Strooom/LoRa-V3-Mini-PCB/outputs/reports/PCB design-rule-check report.html

Logo

| DRC report for LoRa-V3-Mini-PCB
| PCB: LoRa-V3-Mini-PCB Revision: None Date: 2025-06-02T10:16:57+0000 KiCad Version: 8.0.8 | Errors: 0 Warnings: 1 Total: 1

Violations

Type | Description | Details
lib_footprint_mismatch | Footprint 'XDCR_ANT-868-CHP-T' does not match copy in library '1projectLibrary'. | @(171.91 mm, 107.25 mm): Footprint ANT1

Generated by KiBot (https://github.com/INTI-CMNB/KiBot/) v1.8.5
