Strooom/LoRa-V3-Mini-PCB/outputs/reports/schematic electrical-rule-check report.html

Logo

| ERC report for LoRa-V3-Mini-PCB
| Schematic: LoRa-V3-Mini-PCB Revision: V1.2 Date: 2025-06-02T10:16:55+0000 KiCad Version: 8.0.8 | Errors: 0 Warnings: 3 Total: 3

Sheet / (LoRa-V3-Mini-PCB.kicad_sch)

Type | Description | Details
global_label_dangling | Global label not connected anywhere else in the schematic | @(2.3749 mm, 0.762 mm): Global Label 'TEST0'
lib_symbol_issues | The current configuration does not include the library '1GlobalSymbolsLibrary' | @(2.2352 mm, 1.4351 mm): Symbol SW2 [Switch_435451019820]
lib_symbol_issues | The current configuration does not include the library '1GlobalSymbolsLibrary' | @(0.4445 mm, 0.9779 mm): Symbol U3 [SHT40]

Generated by KiBot (https://github.com/INTI-CMNB/KiBot/) v1.8.5
