Strooom/LoRa-V3-Mini-PCB/outputs/bom/LoRa-V3-Mini-PCB-bom.html

 | KiBot Bill of Materials
 | Schematic: LoRa-V3-Mini-PCB Variant: default Revision: V1.2 Date: 2024-07-26 KiCad Version: 8.0.8+1 | Component Groups: 14 Component Count: 20 (per PCB) Fitted Components: 20 (per PCB) Number of PCBs: 1 Total Components: 20 (for 1 PCBs)
References | Part | Value | Quantity Per PCB | manufacturerName | manufacturerPartNumber | octopartUrl
ANT1 | Antenna_Chip | Chip Antenna | 1 | TE Connectivity Linx | ANT-868-CHP-T | https://octopart.com/search?q=ANT-868-CHP-T¤cy=USD&specs=0
BH1 | Battery_Cell | Battery Holder | 1 | KeyStone | 108 | https://octopart.com/108-keystone-11058
C1 C2 C3 C5 | C | 100nF | 4 | TDK | CGA3E2X7R1E104K080AA | https://octopart.com/cga3e2x7r1e104k080aa-tdk-25947977?r=sp
C10 C11 | C | 4.7uF | 2 | Samsung | CL21B475KPFNFNE | https://octopart.com/cl21b475kpfnfne-samsung+electro-mechanics-24958210
CONN2 | CLI_Conn_01x03_Pin | UART2 - CLI | 1 | NA | NA | NA
Q1 | Si2367DS | NA | 1 | Vishay Siliconix | SI2367DS-T1-GE3 | https://octopart.com/si2367ds-t1-ge3-vishay-42637886?r=sp
R1 R2 R3 | R | 4K7 | 3 | YAGEO | CR0603-FX-4701ELF | https://octopart.com/cr0603-fx-4701elf-bourns-3867100?r=sp
R4 | R | 330K | 1 | YAGEO | AC0603JR-07330KL | https://octopart.com/ac0603jr-07330kl-yageo-30510863
SW1 | Switch_434331045822 | Application Button | 1 | Wurth Electronics | 434331045822 | https://octopart.com/434331045822-wurth+elektronik-22866031
SW2 | Switch_435451019820 | MCU Reset | 1 | Wurth Elektronik | 434133025816 | https://octopart.com/434133025816-wurth+elektronik-99472342
U2 | BR24G1MFVT | BR24G1MFVT | 1 | ROHM | BR24G1MFVT-5AE2 | https://octopart.com/br24g1mfvt-5ae2-rohm-126430213?r=sp
U3 | SHT40 | SHT40 | 1 | Sensirion | SHT40-BD1B-R2 | https://octopart.com/sht40-bd1b-r2-sensirion-137454263?r=sp
U1 | Seeed_Wio-E5 | Seeed_Wio-E5 LE | 1 | Seeed Technology | 114993121 | https://octopart.com/114993121-seeed+studio-142683940?r=sp
U4 | TSL2591 | TSL25911 | 1 | ams Osram | TSL25911FN | https://octopart.com/tsl25911fn-osram-126135547?r=sp
Color reference for columns:
KiCad Fields (default)
Generated Fields
User Fields
Empty Fields
