Strooom/LoRa-V3-Mini-PCB/outputs/bom/kicost-bom.xlsx

Prj: | kicost-bom.csv |  |  |  | Board Qty: | 100
Co.: |  |  |  |  | Unit Cost: | €97.44
Prj date: | 2025-03-11 14:46:47 (file) |  |  |  | Total Cost: | €9743.70 |  |  |  |  | €9743.70 | 14 of 14 parts found
$ date: | 2025-03-12 16:15:15
Global Part Info |  |  |  |  |  |  | Mouser
Refs | Value | Footprint | Manf# | Qty | Unit$ | Ext$ | Avail | Purch | Unit$ | MOQ | Ext$ | Cat#
ANT1 | ??? | ??? | ANT-868-CHP-T (https://www.mouser.com/datasheet/2/418/9/lnncs00024_1-3238509.pdf) | 100 | €2.620 | €262.00 | 643 |  | €2.620 | 1 | €262.00 | 712-ANT-868-CHP-T (https://www.mouser.be/ProductDetail/TE-Connectivity-Linx-Technologies/ANT-868-CHP-T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)
BH1 | ??? | ??? | 108 (https://www.mouser.com/datasheet/2/643/ds_st_rectifiers_series-1384684.pdf) | 100 | €81.890 | €8189.00 | NonStk |  | €81.890 | 1 | €8189.00 | 530-10-8 (https://www.mouser.be/ProductDetail/Bel-Signal-Transformer/10-8?qs=0%2F2GmT7MRM%2FiGa7OCQo%252Bvw%3D%3D)
C1-C3,C5 | ??? | ??? | CGA3E2X7R1E104K080AA | 400 | €0.019 | €7.60 | 928170 |  | €0.019 | 1 | €7.60 | 810-CGA3E2X7R1E104K (https://www.mouser.be/ProductDetail/TDK/CGA3E2X7R1E104K080AA?qs=NRhsANhppD%2Fm7%2FOmmsm0vg%3D%3D)
C10,C11 | ??? | ??? | CL21B475KPFNFNE (https://www.mouser.com/datasheet/2/585/MLCC-1837944.pdf) | 200 | €0.105 | €21.00 | 16674 |  | €0.105 | 1 | €21.00 | 187-CL21B475KPFNFNE (https://www.mouser.be/ProductDetail/Samsung-Electro-Mechanics/CL21B475KPFNFNE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)
CONN2 | ??? | ??? | NA (https://www.mouser.com/datasheet/2/1628/ac_c5_na-3519839.pdf) | 100 |  |  | NonStk |  |  | 700 |  | 179-AC-C5-L-BNA (https://www.mouser.be/ProductDetail/Same-Sky/AC-C5-L-B-NA?qs=%252BXxaIXUDbq377a9viFQN2A%3D%3D)
Q1 | ??? | ??? | SI2367DS-T1-GE3 | 100 | €0.245 | €24.50 | 5668 |  | €0.245 | 1 | €24.50 | 781-SI2367DS-GE3 (https://www.mouser.be/ProductDetail/Vishay-Semiconductors/SI2367DS-T1-GE3?qs=kt16UJ73eEHbeglRjuryig%3D%3D)
R1-R3 | ??? | ??? | CR0603-FX-4701ELF (https://www.mouser.com/datasheet/2/54/cr-1858361.pdf) | 300 | €0.008 | €2.40 | 190615 |  | €0.008 | 1 | €2.40 | 652-CR0603FX-4701ELF (https://www.mouser.be/ProductDetail/Bourns/CR0603-FX-4701ELF?qs=CCIlxZRRv7jGwxSydcgiTA%3D%3D)
R4 | ??? | ??? | AC0603JR-07330KL (https://www.mouser.com/datasheet/2/447/PYu_AC_51_RoHS_L_11-3418659.pdf) | 100 | €0.007 | €0.70 | 64642 |  | €0.007 | 1 | €0.70 | 603-AC0603JR-07330KL (https://www.mouser.be/ProductDetail/YAGEO/AC0603JR-07330KL?qs=ygRr%2FtkhteswRX2BvSPS%2Fg%3D%3D)
SW1 | ??? | ??? | 434351045816 | 100 | €0.466 | €46.60 | 2739 |  | €0.466 | 1 | €46.60 | 710-434351045816 (https://www.mouser.be/ProductDetail/Wurth-Elektronik/434351045816?qs=wr8lucFkNMUGT%2FvJONN5XA%3D%3D)
SW2 | ??? | ??? | 434133025816 | 100 | €0.469 | €46.90 | 2166 |  | €0.469 | 1 | €46.90 | 710-434133025816 (https://www.mouser.be/ProductDetail/Wurth-Elektronik/434133025816?qs=sPbYRqrBIVmKpJ9kaO4kMw%3D%3D)
U1 | ??? | ??? | 114993121 (https://www.mouser.com/datasheet/2/744/Wio_E5_LE_module_datasheet_v1_0-3446934.pdf) | 100 | €7.640 | €764.00 | 96 |  | €7.640 | 1 | €764.00 | 713-114993121 (https://www.mouser.be/ProductDetail/Seeed-Studio/114993121?qs=QpmGXVUTftF1SD6oRXq2Mw%3D%3D)
U2 | ??? | ??? | BR24G1MFVT-5AE2 | 100 | €1.210 | €121.00 | 3347 |  | €1.210 | 1 | €121.00 | 755-BR24G1MFVT-5AE2 (https://www.mouser.be/ProductDetail/ROHM-Semiconductor/BR24G1MFVT-5AE2?qs=MyNHzdoqoQKnzx5taP2O%252BA%3D%3D)
U3 | ??? | ??? | SHT40-BD1B-R2 (https://www.mouser.com/datasheet/2/682/HT_DS_Datasheet_SHT4x_3-2936319.pdf) | 100 | €1.160 | €116.00 | 3188 |  | €1.160 | 1 | €116.00 | 403-SHT40-BD1B-R2 (https://www.mouser.be/ProductDetail/Sensirion/SHT40-BD1B-R2?qs=ulEaXIWI0c%252BjgdkzNQkrGw%3D%3D)
U4 | ??? | ??? | TSL25911FN (https://www.mouser.com/datasheet/2/588/asset_pdf_25493382-3432823.pdf) | 100 | €1.420 | €142.00 | 8371 |  | €1.420 | 1 | €142.00 | 985-TSL25911FN (https://www.mouser.be/ProductDetail/ams-OSRAM/TSL25911FN?qs=6irNfxKJ9AaiNMbaQmyIug%3D%3D)
 |  |  |  |  | Total Purchase: | €0.00 | Buy here (https://mouser.com/bom/) |  |  |  | €0.00
KiCost® v1.1.19 |  |  |  |  | Purchase description:
