Strooom/LoRa-V3-Mini-PCB/inputs/3dmodels/TSSOP8.STEP

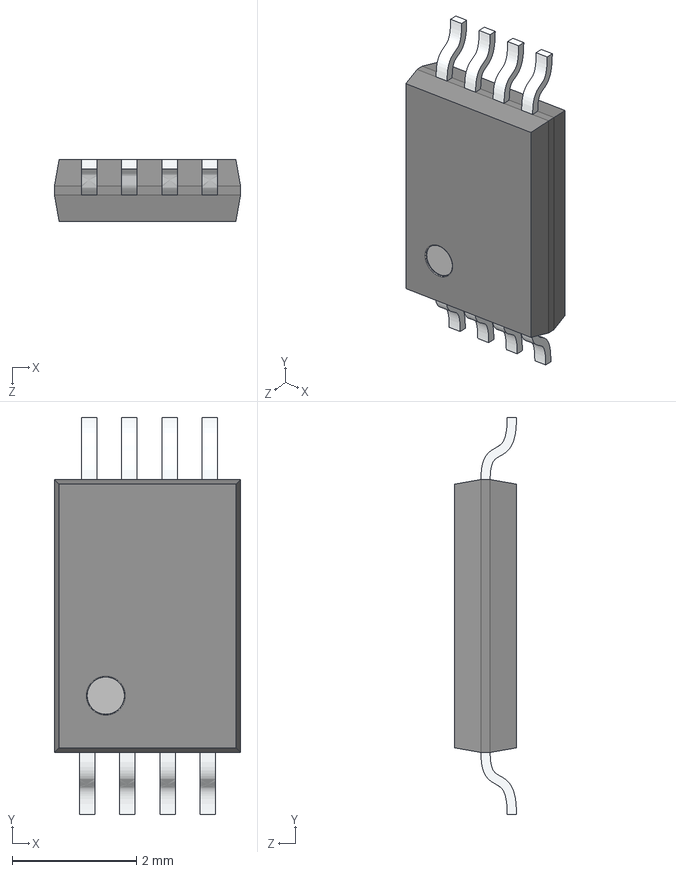
[picture p2: CAD file, 2025-03-11]
inputs/3dmodels/TSSOP8.STEP
3.00 x 6.40 x 1.00 mm
