Strooom/LoRa-V3-Mini-PCB/outputs/pcb/LoRa-V3-Mini-PCB-3D.step

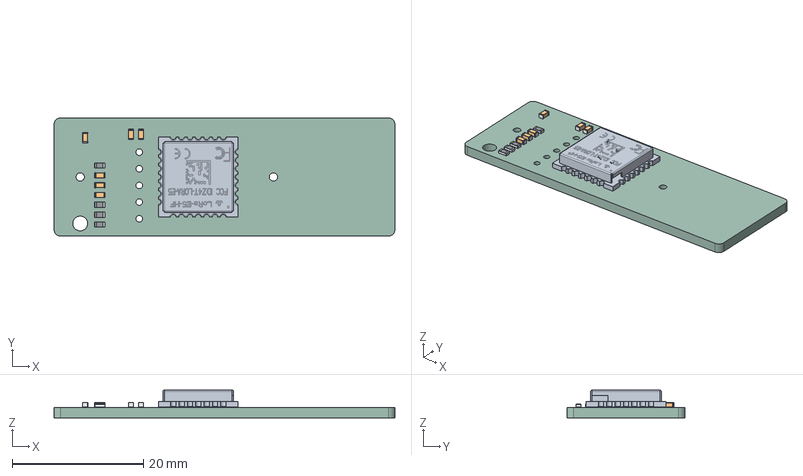
[picture p3: CAD file, 2024-10-09]
outputs/pcb/LoRa-V3-Mini-PCB-3D.step
52.0 x 18.0 x 4.26 mm
LORA-E5-HF00
kibot_l9_deagh_PCB
