Strooom/LoRa-V3-Mini-PCB/inputs/3dmodels/SON-06-FN_2000X2400_AMS.step

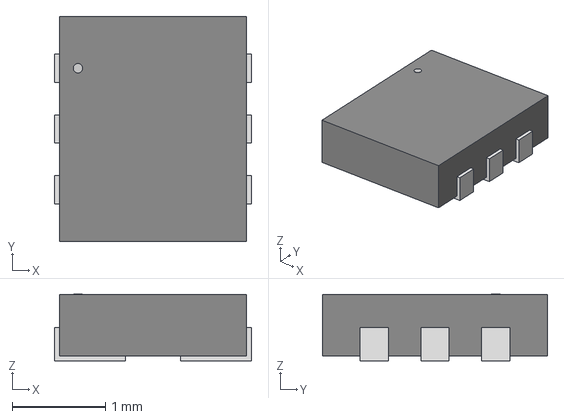
[picture p4: CAD file, 2025-03-11]
inputs/3dmodels/SON-06-FN_2000X2400_AMS.step
2.11 x 2.41 x 0.714 mm
