Strooom/LoRa-V3-Mini-PCB/inputs/3dmodels/Saft 14250.step

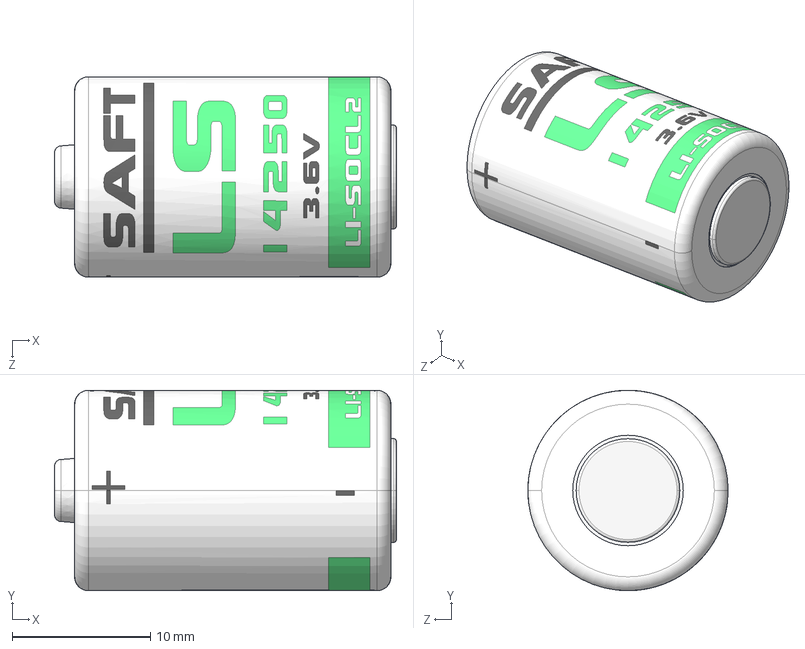
[picture p5: CAD file, 2025-03-11]
inputs/3dmodels/Saft 14250.step
24.8 x 14.5 x 14.5 mm
