Strooom/LoRa-V3-Mini-PCB/inputs/3dmodels/SOT23.STEP

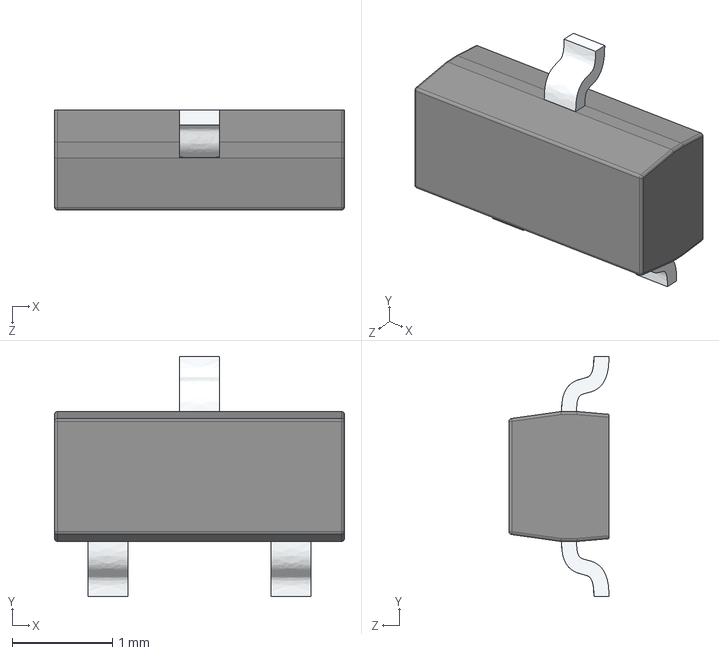
[picture p7: CAD file, 2025-03-11]
inputs/3dmodels/SOT23.STEP
2.90 x 2.40 x 1.00 mm
