Strooom/LoRa-V3-Mini-PCB/inputs/3dmodels/SHT40-AD1B-R2.step

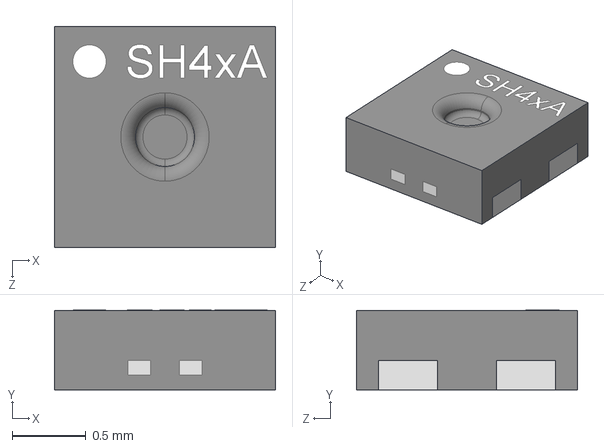
[picture p8: CAD file, 2024-10-09]
inputs/3dmodels/SHT40-AD1B-R2.step
1.50 x 0.541 x 1.50 mm
