Strooom/LoRa-V3-Mini-PCB/inputs/3dmodels/Keystone-108.stp

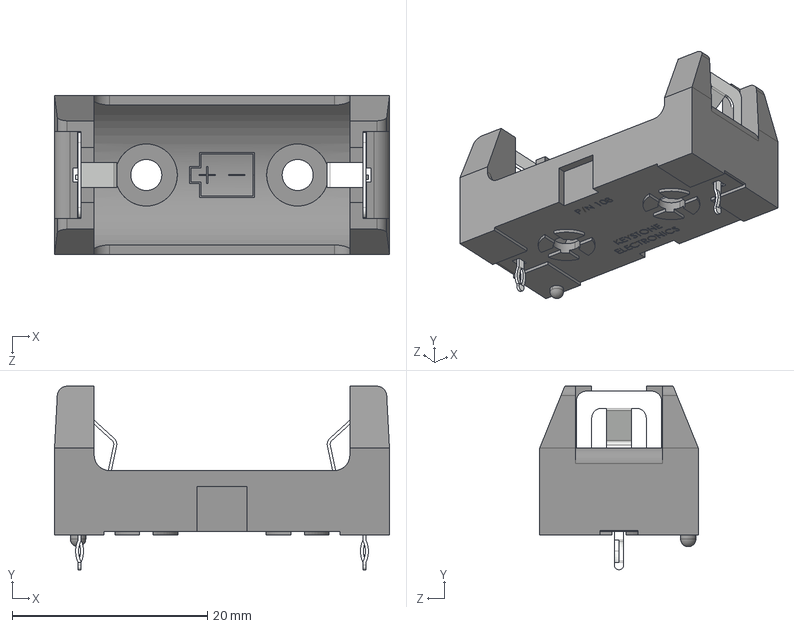
[picture p9: CAD file, 2024-10-09]
inputs/3dmodels/Keystone-108.stp
34.3 x 18.8 x 16.3 mm
