Strooom/LoRa-V3-Mini-PCB/inputs/3dmodels/LoRa-E5-HF_3D_File.stp

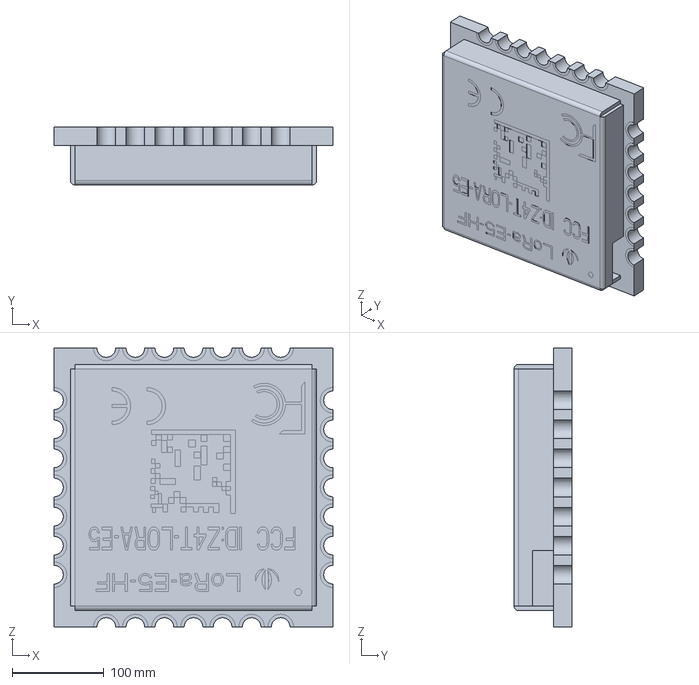
[picture p10: CAD file, 2024-10-09]
inputs/3dmodels/LoRa-E5-HF_3D_File.stp
304.8 x 63.8 x 304.8 mm
