Strooom/LoRa-V3-Mini-PCB/inputs/3dmodels/ANT-868-CHP-T.step

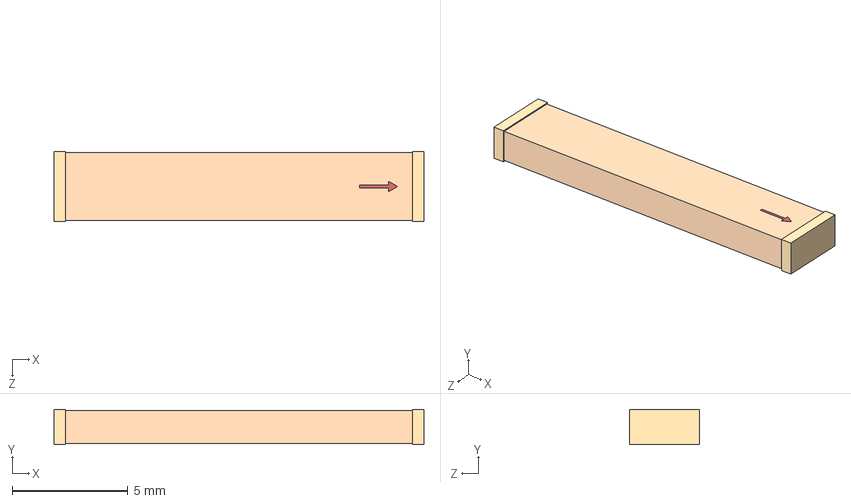
[picture p11: CAD file, 2024-10-09]
inputs/3dmodels/ANT-868-CHP-T.step
16.0 x 1.52 x 3.05 mm
