Strooom/LoRa-V3-Mini-PCB/inputs/3dmodels/R0603.step

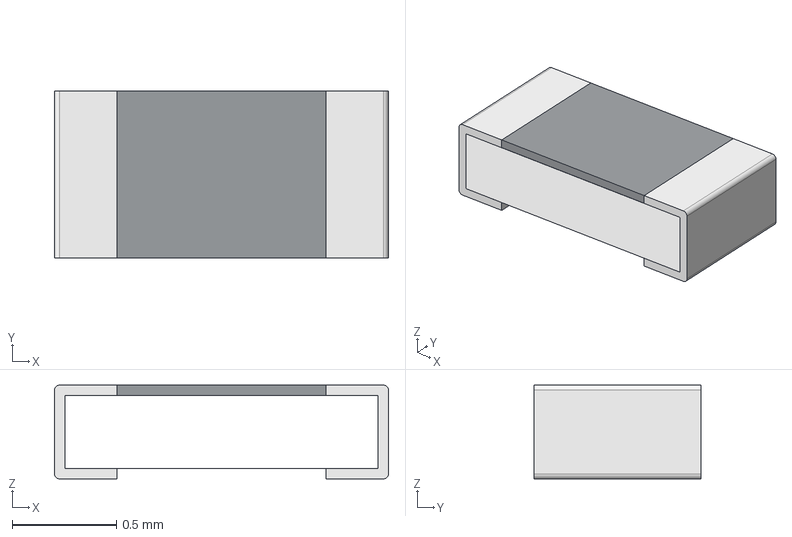
[picture p12: CAD file, 2024-10-09]
inputs/3dmodels/R0603.step
1.60 x 0.8 x 0.45 mm
