Strooom/LoRa-V3-Mini-PCB/inputs/3dmodels/434331045822.stp

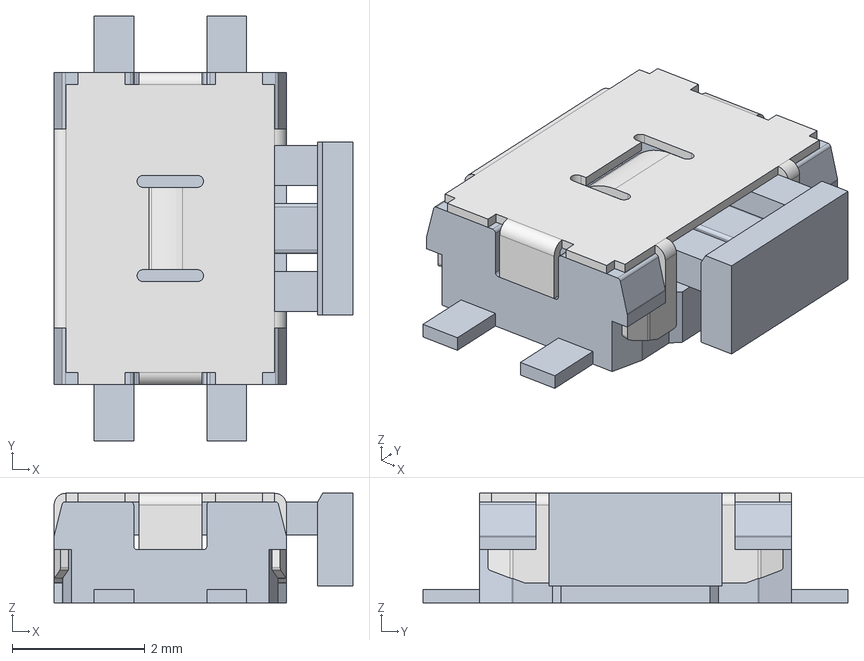
[picture p14: CAD file, 2025-03-11]
inputs/3dmodels/434331045822.stp
4.50 x 6.40 x 1.65 mm
