Strooom/LoRa-V3-Mini-PCB/inputs/3dmodels/4341x30258x6.stp

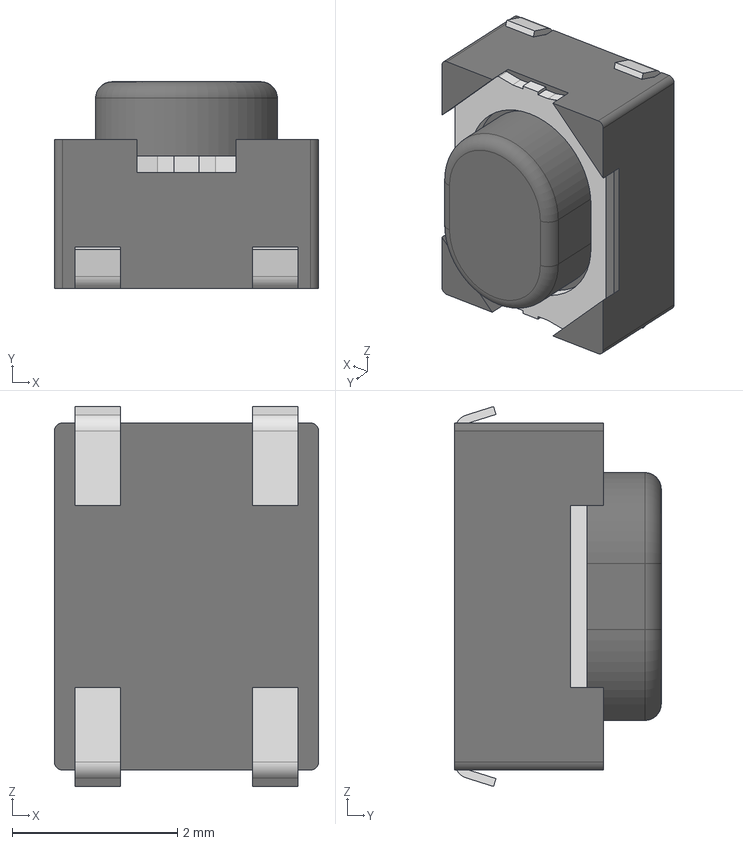
[picture p15: CAD file, 2025-03-11]
inputs/3dmodels/4341x30258x6.stp
3.20 x 2.50 x 4.60 mm
Frame
Cover
Stem
Terminal x 4
