Strooom/LoRa-V3-Mini-PCB/outputs/schematic/LoRa-V3-Mini-PCB-schematic.pdf

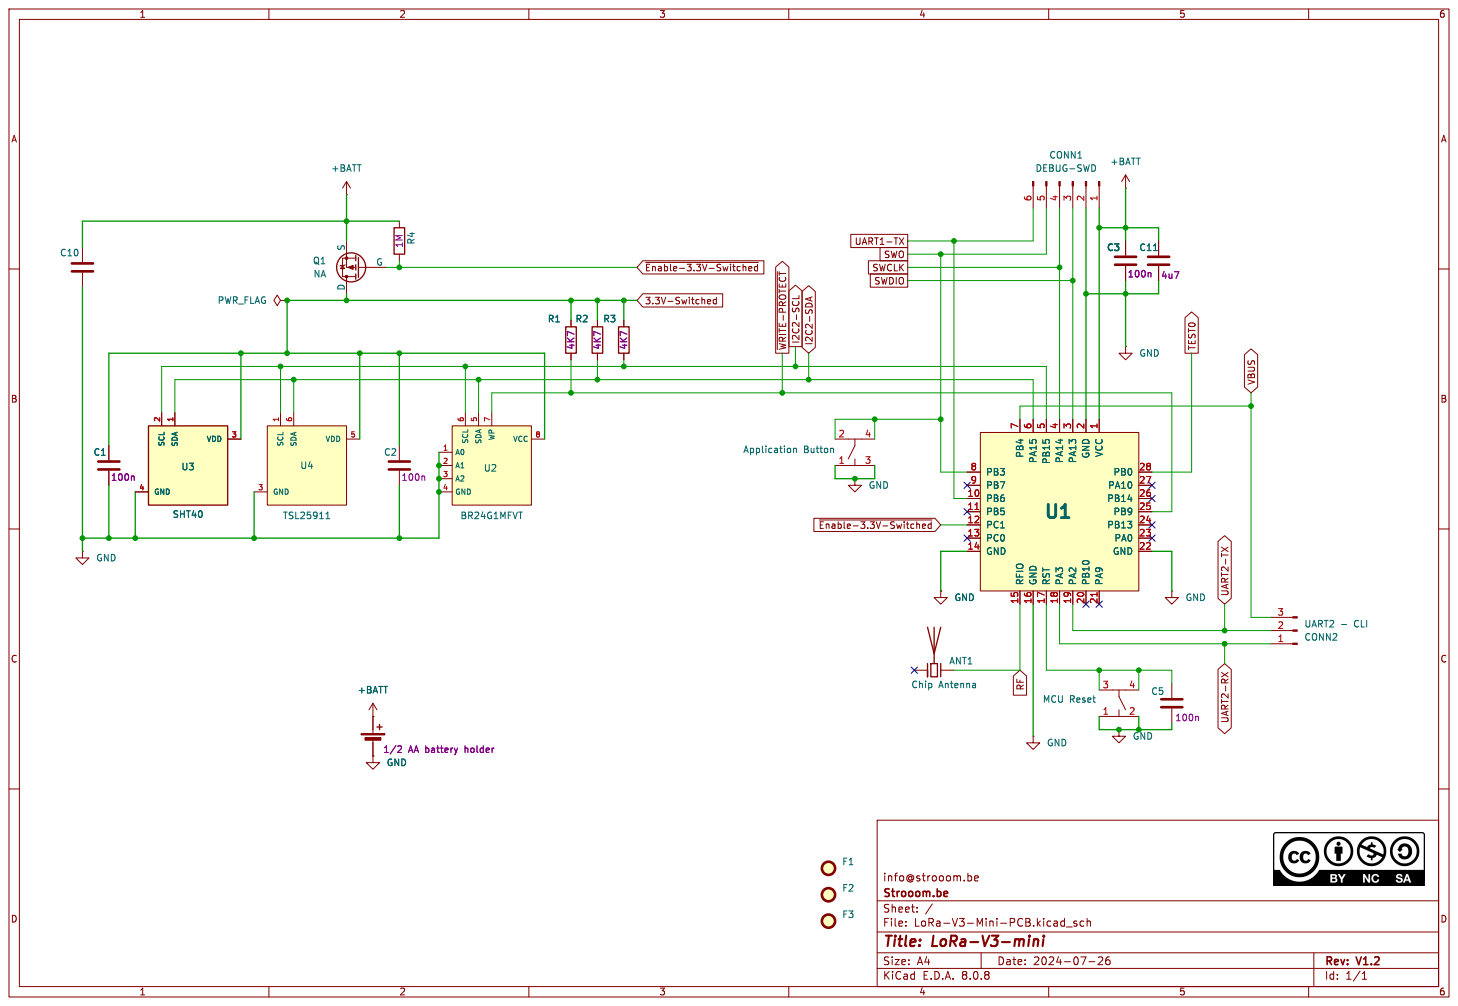
[picture p16: page 1]

1 PB6 10 PB5 11 PC1 12 PC0 13 GND 14 RFIO 15 GND 16 RST 17 PA3 18 PA2 19 GND

info@strooom.be
Id: 1/1 Title: LoRa-V3-mini File: LoRa-V3-Mini-PCB.kicad_sch Sheet: / Strooom.be
