Strooom/LoRa-V3-Mini-PCB/LoRa-V3-Mini-PCB.pdf

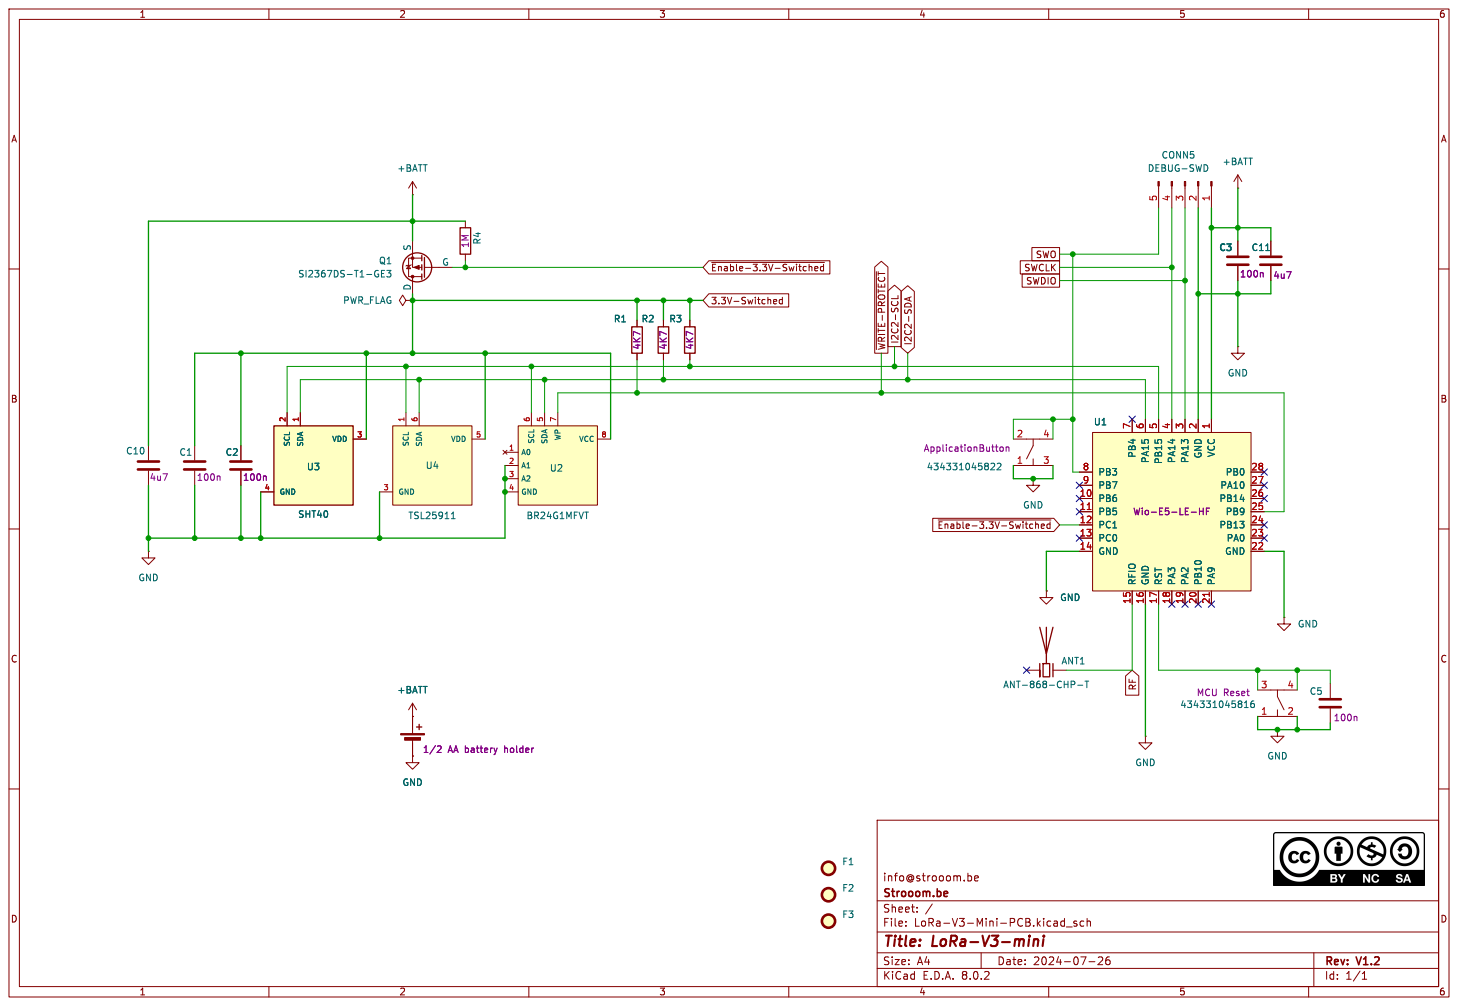
[picture p17: page 1]
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

1/2 AA battery holder GND

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
