Strooom/LoRa-V3-Mini-PCB/outputs/pcb/LoRa-V3-Mini-PCB-assembly.pdf

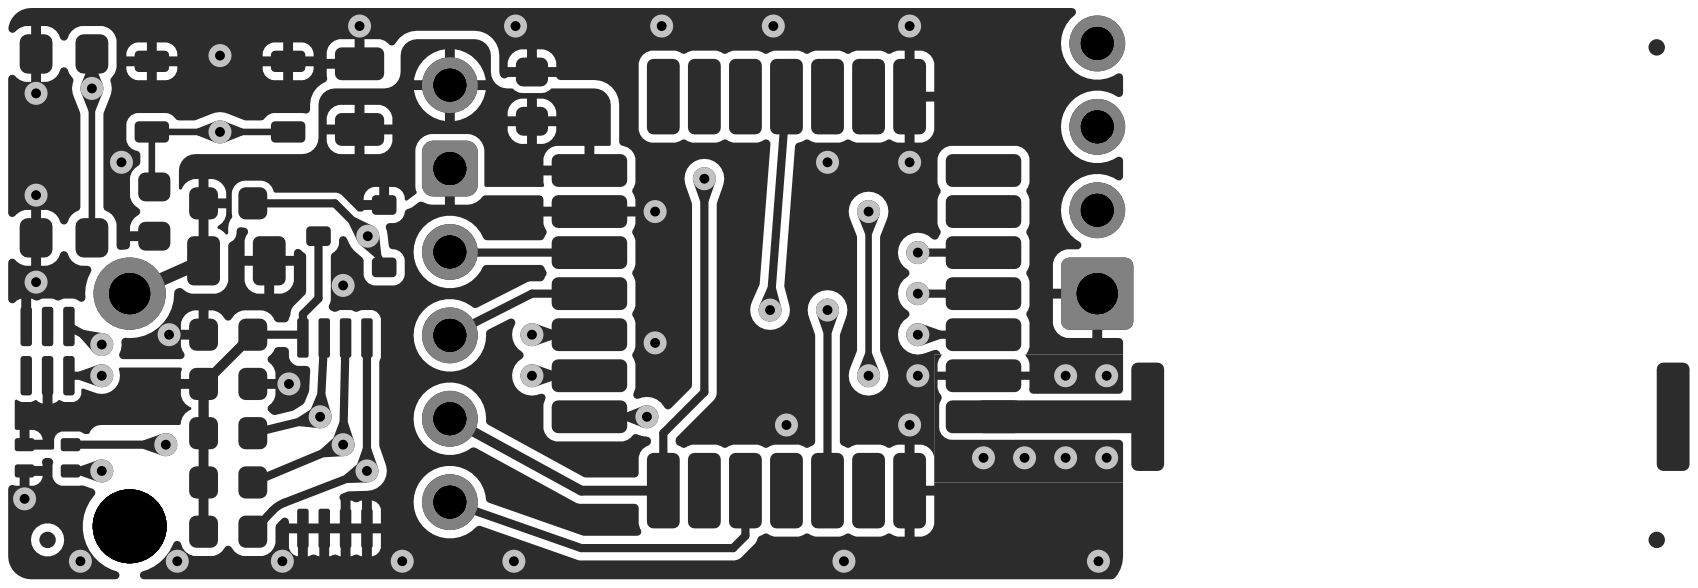
[picture p18: page 1]

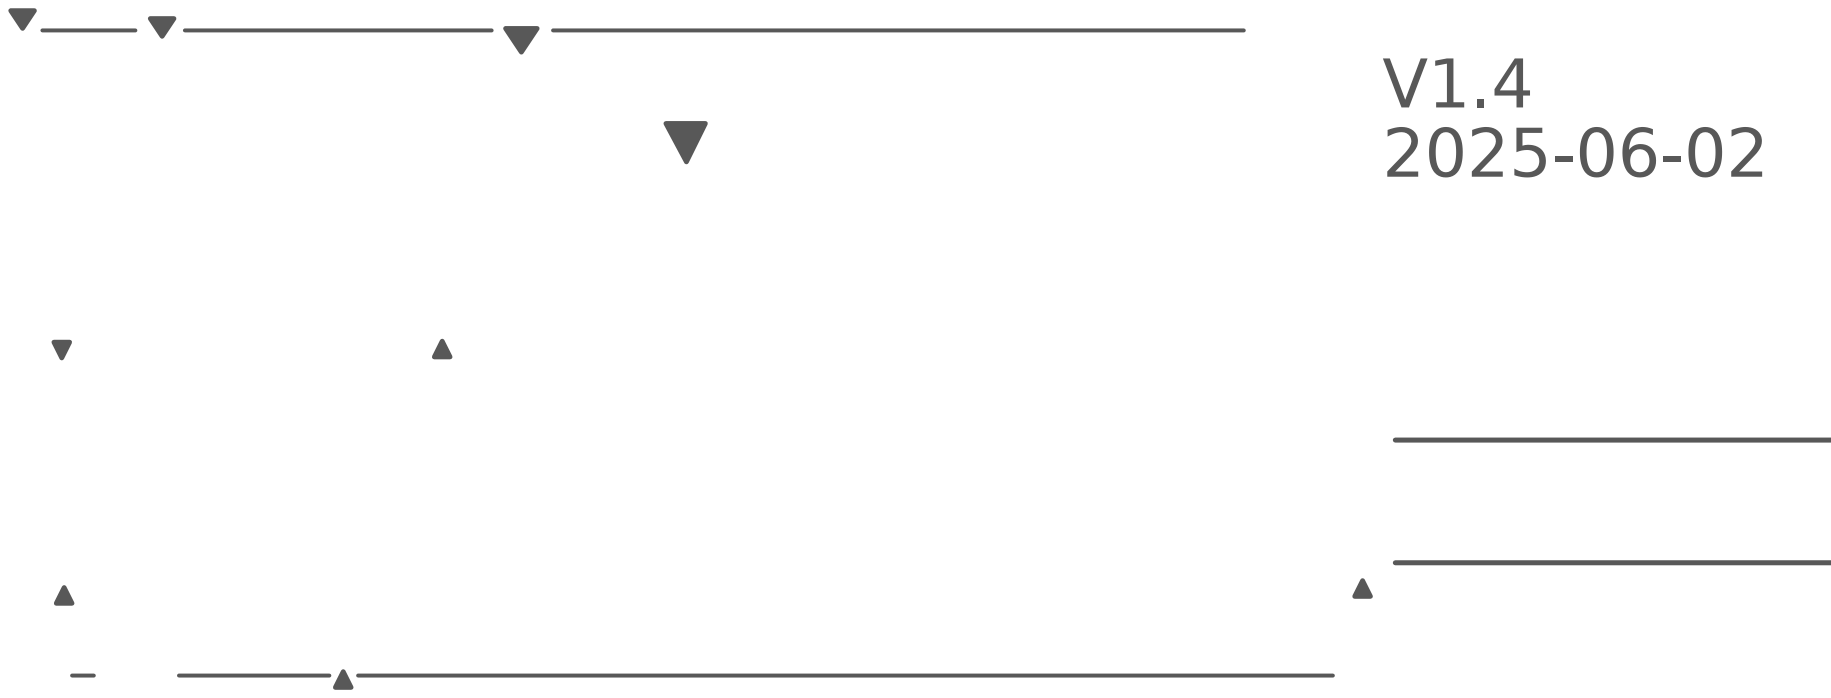
[picture p19: page 2]

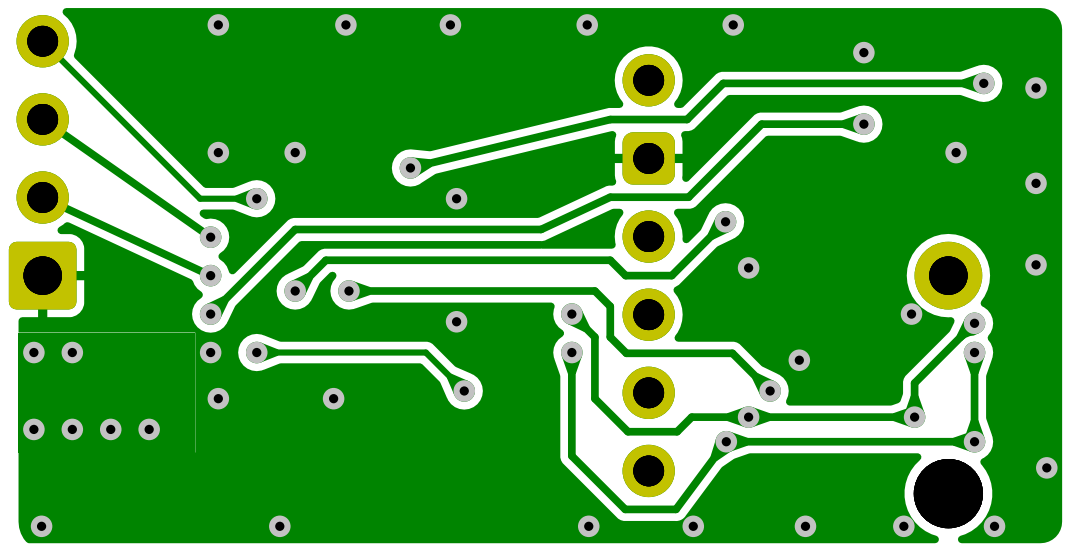
[picture p20: page 3]

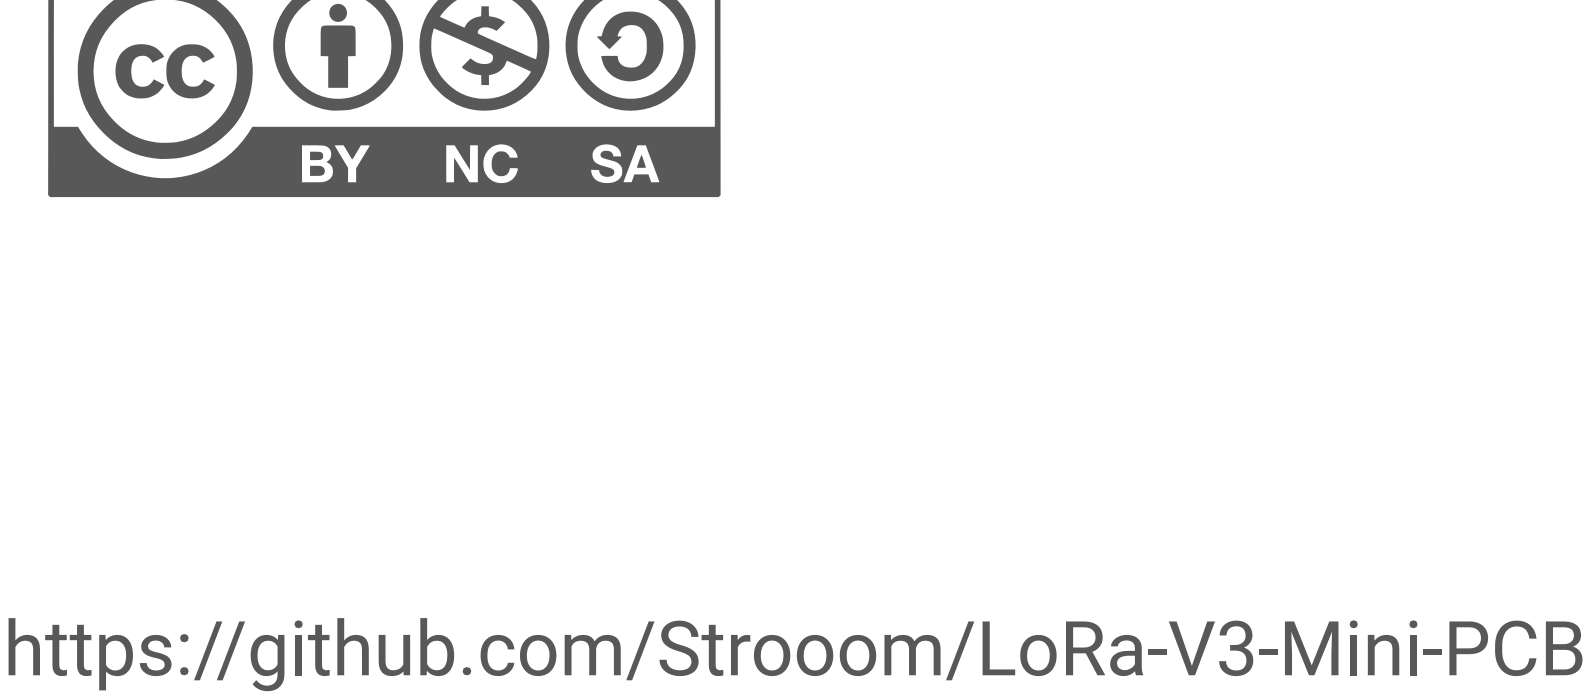
[picture p21: page 4]
