Strooom/LoRa-V3-Mini-PCB/LoRa-V3-Mini-PCB.kicad_pcb

## KiCad design LoRa-V3-Mini-PCB.kicad_pcb (2025-06-02)

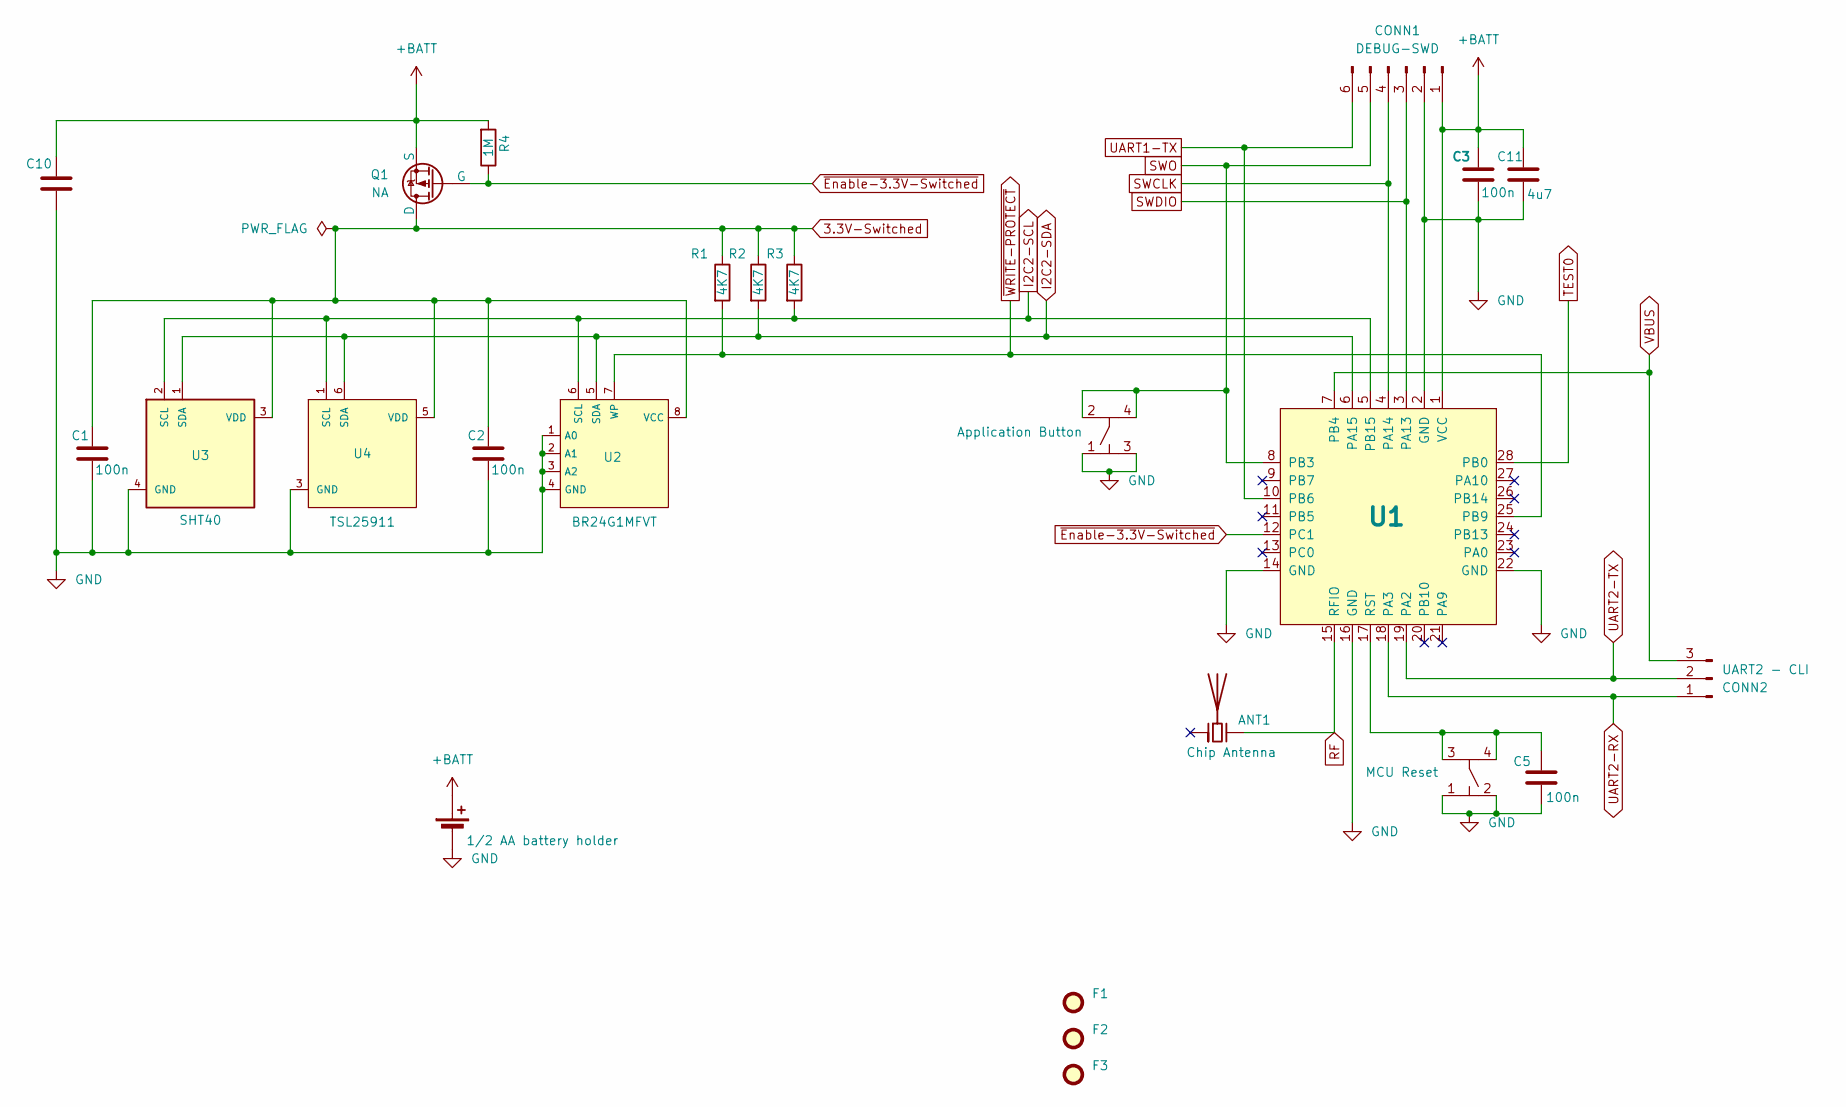
[picture p22: schematic LoRa-V3-Mini-PCB.kicad_sch, LoRa-V3-mini]

Parts:
ANT1: Chip Antenna; XDCR_ANT-868-CHP-T; manufacturerPartNumber ANT-868-CHP-T
BH1: Battery Holder; 108_Keystone; manufacturerPartNumber 108
C1, C2, C3, C5: 100nF; C_0603_nominal; manufacturerPartNumber CGA3E2X7R1E104K080AA
C10, C11: 4.7uF; C_0805; manufacturerPartNumber CL21B475KPFNFNE
CONN1: DEBUG-SWD; DebugConnector_1x06_P2.54mm; manufacturerPartNumber NA
CONN2: UART2 - CLI; CliConnector_3p; manufacturerPartNumber NA
F1, F2, F3: Fiducial; Fiducial_0.5mm_Mask1mm; manufacturerPartNumber NA
Q1: NA; SI2367DS-SOT-23; manufacturerPartNumber SI2367DS-T1-GE3
R1, R2, R3: 4K7; R_0603_nominal; manufacturerPartNumber CR0603-FX-4701ELF
R4: 330K; R_0603_nominal; manufacturerPartNumber AC0603JR-07330KL
SW1: Application Button; 4343X10458XX; manufacturerPartNumber 434331045822
SW2: MCU Reset; 4341330258X6; manufacturerPartNumber 434133025816
U1: Seeed_Wio-E5 LE; LoRa-E5; manufacturerPartNumber 114993121
U2: BR24G1MFVT; BR24G1M-TSSOP-B8; manufacturerPartNumber BR24G1MFVT-5AE2
U3: SHT40; SHT4X; manufacturerPartNumber SHT40-BD1B-R2
U4: TSL25911; TSL2591-SON; manufacturerPartNumber TSL25911FN

Connections:
3.3V-Switched: C1.1, C2.1, Q1.3 (D), R1.1, R2.1, R3.1, U2.8 (VCC), U3.3 (VDD), U4.5 (VDD)
+BATT: BH1.1 (+), C3.1, C10.1, C11.1, CONN1.1, Q1.2 (S), R4.2, U1.1 (VCC)
GND: BH1.2 (-), C1.2, C2.2, C3.2, C5.2, C10.2, C11.2, CONN1.2, SW1.1, SW1.3, SW2.1, SW2.2, U1.2 (GND), U1.14 (GND), U1.16 (GND), U1.22 (GND), U2.1 (A0), U2.2 (A1), U2.3 (A2), U2.4 (GND), U3.4 (GND), U4.3 (GND)
I2C2-SCL: R3.2, U1.5 (PB15), U2.6 (SCL), U3.2 (SCL), U4.1 (SCL)
I2C2-SDA: R2.2, U1.6 (PA15), U2.5 (SDA), U3.1 (SDA), U4.6 (SDA)
unnamed: C5.1, SW2.3, SW2.4, U1.17 (RST)
RF: ANT1.1 (FEED), U1.15 (RFIO)
SWCLK: CONN1.4, U1.4 (PA14)
SWDIO: CONN1.3, U1.3 (PA13)
SWO: CONN1.5, SW1.2, SW1.4, U1.8 (PB3)
TEST0: U1.28 (PB0)
UART1-TX: CONN1.6, U1.10 (PB6)
UART2-RX: CONN2.1, U1.18 (PA3)
UART2-TX: CONN2.2, U1.19 (PA2)
VBUS: CONN2.3, U1.7 (PB4)
~Enable-3.3V-Switched: Q1.1 (G), R4.1, U1.12 (PC1)
~WRITE-PROTECT: R1.2, U1.25 (PB9), U2.7 (WP)

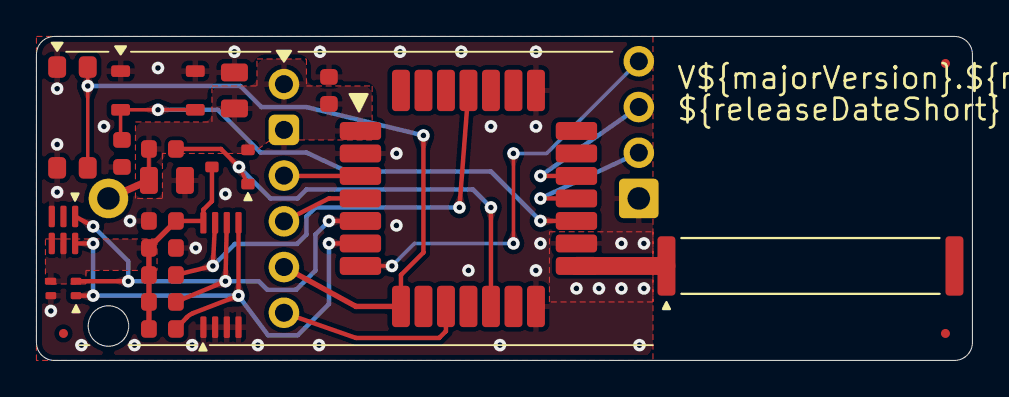
[picture p23: board LoRa-V3-Mini-PCB.kicad_pcb from above]

Board: 2 copper layers, 52.0 x 18.0 mm, 24 parts (1 on the bottom side), 16 nets.
