Strooom/LoRa-V3-Mini-PCB/(commit log)

2024-09-23 add schematic in pdf format
2024-09-23 adding a CI/CD workflow for KiCAD
2024-09-23 Update drcerc.yml
    trying to export pdf schematic
2024-10-09 add workflow generated files
    [LoRa-V3-Mini-PCB-3D.step, LoRa-V3-Mini-PCB-bom.csv]
2024-10-09 move global components into project library
    [C0603.step, LoRa-V3-Mini-PCB.kicad_pcb, LoRa-V3-Mini-PCB.kicad_sch, R0603.step]
2024-10-09 update 3d models / footprints
    [ANT-868-CHP-T.step, Keystone-108.stp, LoRa-E5-HF_3D_File.stp, LoRa-V3-Mini-PCB.kicad_pcb, LoRa-V3-Mini-PCB.kicad_sch, SHT40-AD1B-R2.step]
2024-10-09 using project lib io global
    [LoRa-V3-Mini-PCB.kicad_pcb, LoRa-V3-Mini-PCB.kicad_sch]
2024-10-09 update libraries
    [4341x30258x6.stp, 434331045822.stp, LoRa-V3-Mini-PCB.kicad_pcb, LoRa-V3-Mini-PCB.kicad_sch]
2024-10-10 update application switch
    [LoRa-V3-Mini-PCB.kicad_pcb, LoRa-V3-Mini-PCB.kicad_sch]
2025-01-24 upgraded debug connector with UART1TX
    [LoRa-V3-Mini-PCB.kicad_pcb, LoRa-V3-Mini-PCB.kicad_sch]
2025-01-25 fix 3d-models
    [LoRa-V3-Mini-PCB.kicad_sch, SON-06-FN_2000X2400_AMS.step, TSSOP8.STEP]
2025-01-25 finishing touch to layout
    [LoRa-V3-Mini-PCB.kicad_pcb, LoRa-V3-Mini-PCB.kicad_sch]
2025-01-28 add saft 14250 model to footprint
    to improve exported step file before designing an enclosure
    [Saft 14250.step]
2025-01-28 save file
    [LoRa-V3-Mini-PCB.kicad_pcb]
2025-02-24 change caps to 0805
    [LoRa-V3-Mini-PCB.kicad_pcb, LoRa-V3-Mini-PCB.kicad_sch]
2025-02-24 fix BOM
    [C0805.stp, LoRa-V3-Mini-PCB.kicad_pcb, LoRa-V3-Mini-PCB.kicad_sch]
2025-02-24 add extra csv file for kicost
    [LoRa-V3-Mini-PCB.kicad_sch]
2025-02-24 try fix error on GND needing datasheet...
    [LoRa-V3-Mini-PCB.kicad_pcb, LoRa-V3-Mini-PCB.kicad_sch]
2025-02-24 exclude conn5 from BOM
    [LoRa-V3-Mini-PCB.kicad_sch]
2025-02-24 move decouple cap closer to MCU
    [LoRa-V3-Mini-PCB.kicad_pcb]
2025-03-06 Add Pads for CLI connector
    [LoRa-V3-Mini-PCB.kicad_pcb, LoRa-V3-Mini-PCB.kicad_sch, kicost-bom.xlsx]
2025-03-12 workflow improvements
    reactivate step file output
    correct blender rendering for double output
    [LoRa-V3-Mini-PCB.kicad_pcb]
2025-03-12 move custom bridges for Aisler to other layer
    [LoRa-V3-Mini-PCB.kicad_pcb]
2025-03-19 update bom
    [LoRa-V3-Mini-PCB.kicad_pcb, LoRa-V3-Mini-PCB.kicad_sch, kicost-bom.xlsx]
2025-06-02 add VBUS to detect CLI
    [LoRa-V3-Mini-PCB.kicad_pcb, LoRa-V3-Mini-PCB.kicad_sch]
2025-06-02 fix datasheet for CLI connector
    [LoRa-V3-Mini-PCB.kicad_pcb, LoRa-V3-Mini-PCB.kicad_sch]
